nmiheer715-hue/JalSense/docs/images/dashboard-bypass.png

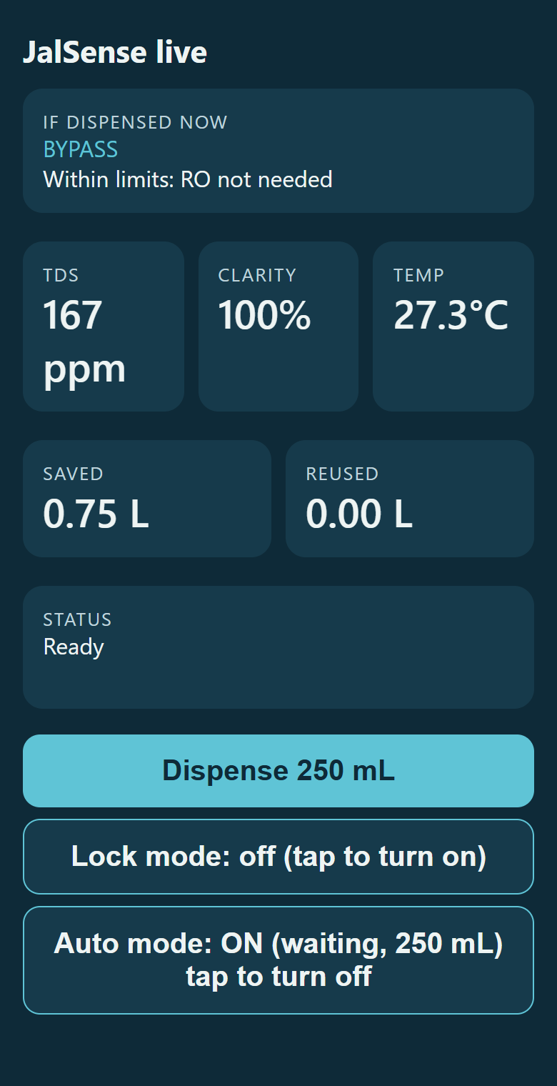
docs/images/dashboard-bypass.png
