nmiheer715-hue/JalSense/docs/images/dashboard-ro.png

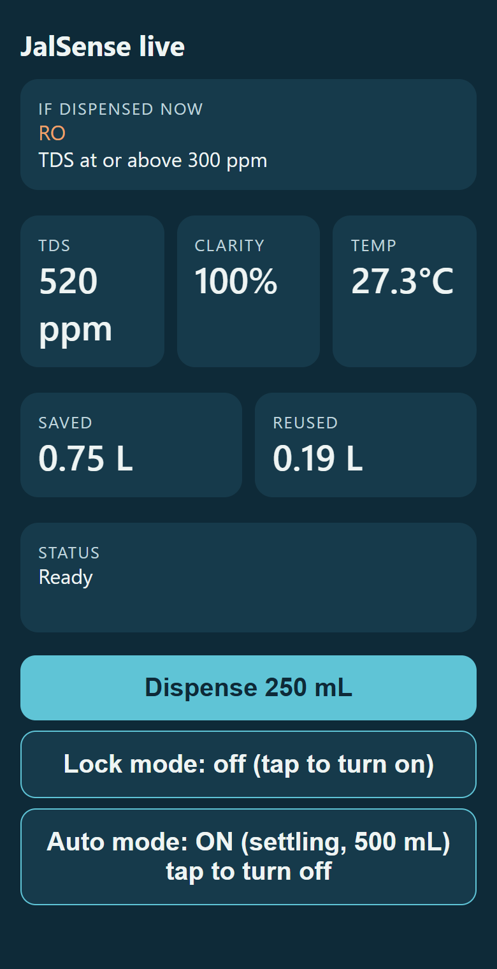
docs/images/dashboard-ro.png
