nmiheer715-hue/JalSense/hardware/jalsense-retrofit-exploded-view.png

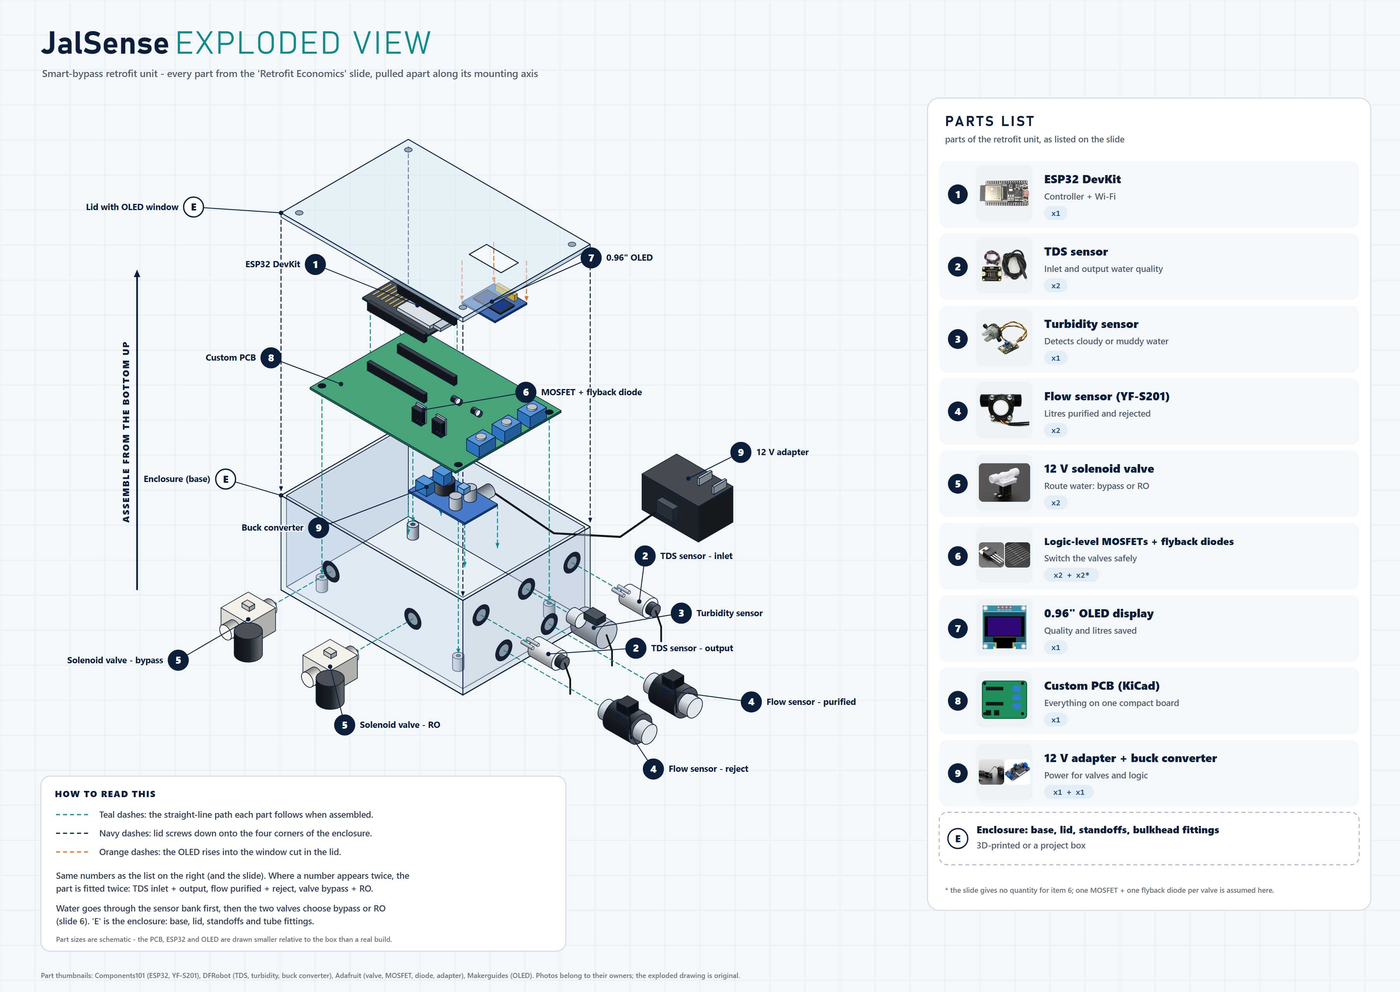
hardware/jalsense-retrofit-exploded-view.png
