nmiheer715-hue/JalSense/hardware/bom.csv

Part | Qty | Job
ESP32-WROOM-32 DevKit (38-pin) | 1 | Controller, Wi-Fi dashboard
Analog TDS meter V1.0 | 1 | Dissolved salts in the inlet water
Turbidity sensor with module | 1 | Detects cloudy water
DS18B20 waterproof probe (1 m) | 1 | Temperature compensation for TDS
YF-S201 water flow sensor | 1 | Litres on the bypass path
5 V dual relay module with optocoupler | 1 | Switches pump A and pump B
DC 3-6 V mini submersible pump | 2 | Pump A = bypass, pump B = RO
0.96" OLED I2C (SSD1306 or SH1106) | 1 | Live readings and decision
5 V 2 A adapter | 1 | Powers everything
DC jack female pigtail 2.1 x 5.5 mm | 1 | Adapter to breadboard rails
MB102 830-point breadboard | 1 | Holds the circuit
Resistors (six of one value: 10k design, 5.5k as built) | 6 | Dividers R1 to R4 and DS18B20 pull-up R5
Capacitor 470 uF 16 V | 1 | Supply dip at pump start
6 mm silicone tube (1 m) | 1 | Pump outlets to the jars
