nmiheer715-hue/JalSense/hardware/jalsense-breadboard-build-v2.png

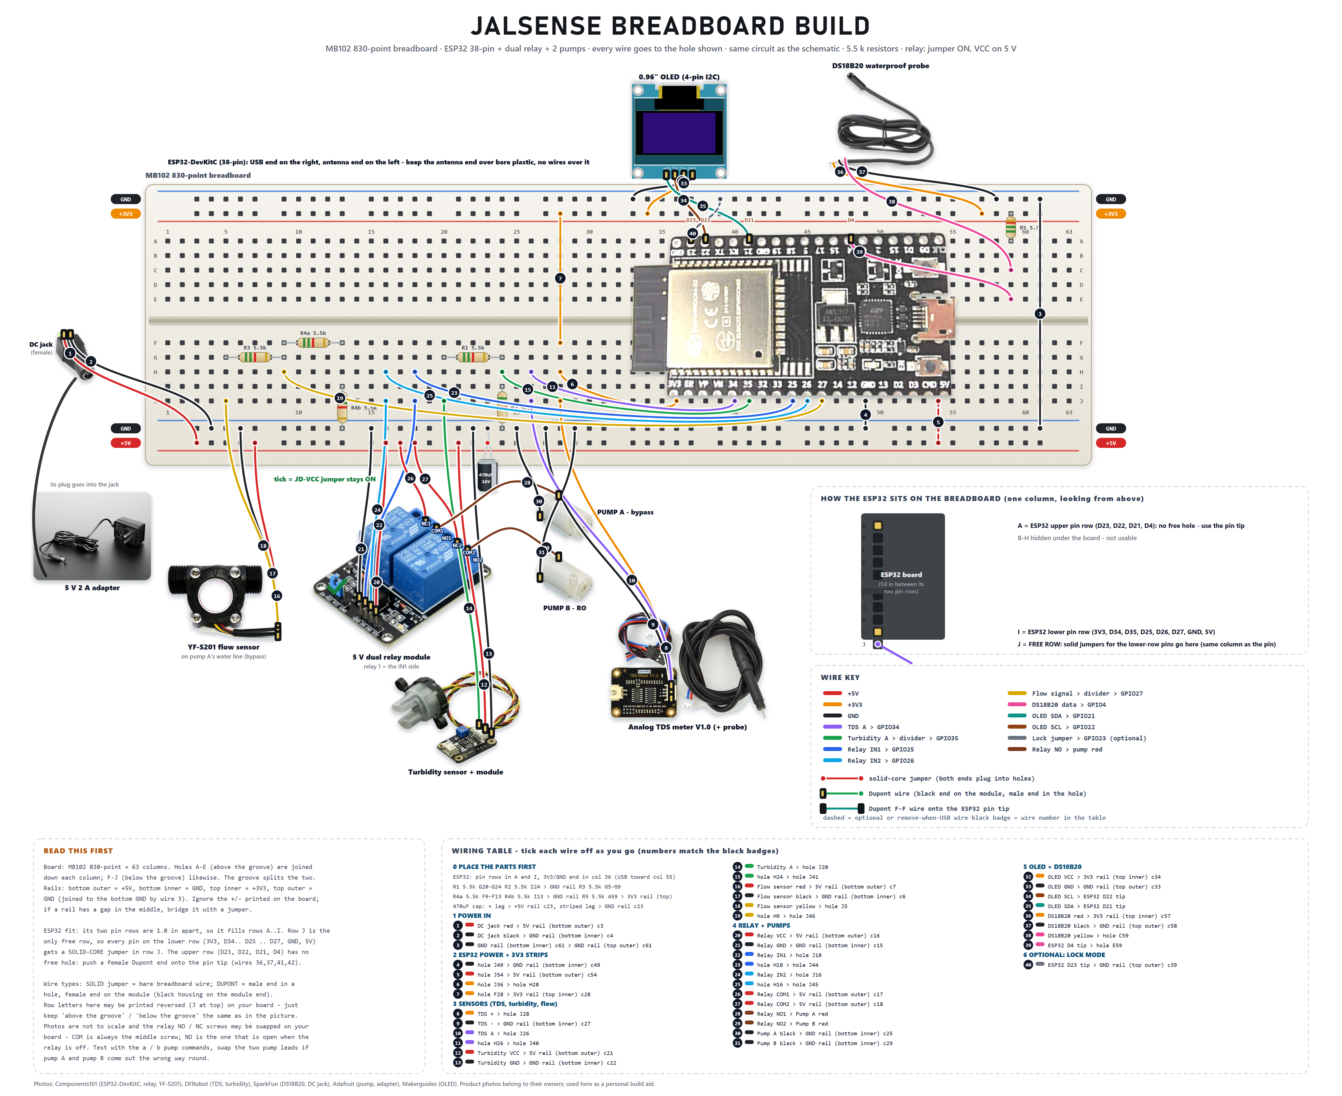
hardware/jalsense-breadboard-build-v2.png
