nmiheer715-hue/JalSense/hardware/jalsense-wiring.png

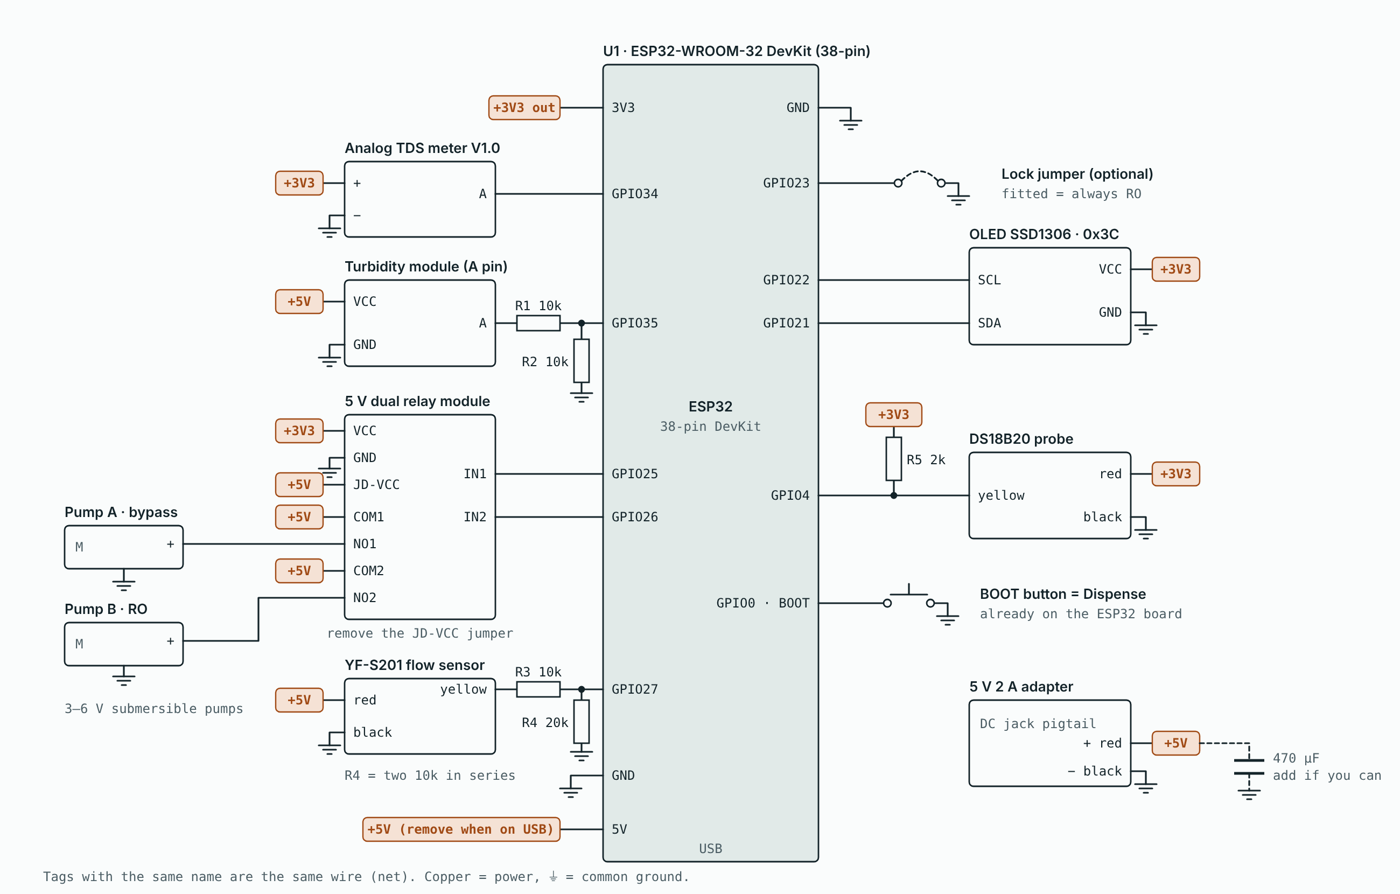
hardware/jalsense-wiring.png
