nmiheer715-hue/JalSense/(commit log)

2026-10-10 JalSense: firmware, schematics and docs for the SDG 6 RO retrofit
    ESP32 firmware with fail-safe bypass/RO decision, ADS1115 sensing,
    flow metering and phone dashboard; three schematic sheets, parts list,
    wiring table, calibration, design notes, FAQ and demo script.
    Claude-Session: https://claude.ai/code/session_01VPnfr1mdaY5D5fYLJCe19C
    [bom.csv]
2026-10-10 Rebuild around the ordered parts: relay + two pumps, ESP32 ADC
    - Firmware: ESP32 ADC sensing (150 mV fault floor), active-LOW dual relay
    driving pump A (bypass) and pump B (RO), flow metering on the bypass
    line, timed metering on the RO path, BOOT button dispense, GPIO23 or
    phone lock mode, pump-rate calibration, Wokwi build flag
    - New wiring diagram (SVG + PNG) replacing the three schematic sheets
    - Wokwi simulation project (diagram.json, sketch, libraries)
    - Parts list, wiring table, calibration, design notes, FAQ, demo script
    and troubleshooting updated; no custom PCB
    Claude-Session: https://claude.ai/code/session_01VPnfr1md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
    [bom.csv]
2026-10-10 Correct prototype parts total to about Rs 2,100
    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
2026-10-18 Check clarity before TDS in the decision logic
    TDS (dissolved salts) and turbidity (suspended particles) are independent,
    so low-TDS water can still be cloudy. Clarity is now checked first so the
    reported reason names the visible problem first. Flowchart, README and
    design notes updated; firmware and Wokwi sketch recompiled.
    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
    [JalSense.ino, sketch.ino]
2026-10-24 Add auto mode firmware, OLED fix, live dashboard docs and prototype notes
    - firmware/JalSense_auto: auto mode with safety limits, SH1106 OLED support, faster Wi-Fi hotspot
    - firmware/tools: OLED_test and OLED_test2 (display and I2C checks)
    - docs: phone dashboard (how to monitor the results), prototype build notes, one-page build and demo guide
    - hardware: schematic of the built prototype (v2)
    - README: latest build, live dashboard section, updated layout
    [JalSense_auto.ino, OLED_test.ino, OLED_test2.ino]
2026-10-24 Update docs and hardware files to match the prototype as built
    - hardware: as-built schematic link, resistor values are ratios (5.5 k built), relay wiring options,
    pump wiring (NO not COM), power notes, SH1106 OLED, 470 uF capacitor in the BOM
    - calibration: TDS single-point calibration range, saturation above 1000 ppm, k check, new settings
    - troubleshooting: OLED SH1106, relay and pump wiring, TDS k, temperature probe, upload and Wi-Fi tips
    - README: prototype power and OLED rows, status (bench prototype running), TDS range limit
    - guide: decision order matches the repo (clarity before TDS)
    [bom.csv]
2026-10-24 Remove all prices; add breadboard layout and exploded views
    - remove every price and the total from the README, hardware README, bom.csv and FAQ
    - hardware: breadboard layout (v2), prototype exploded view (HD and 4K), retrofit exploded view
    (rebuilt without prices), listed in a new Build sheets table with a photo-credit note
    - README: exploded view embedded, links to the sheets
    [bom.csv]
2026-10-24 README: show the as-built schematic on the page
2026-10-24 firmware: faster Wi-Fi hotspot in the original JalSense.ino
    Power-save off, fixed 192.168.4.1, channel 6, up to 2 phones (same settings as JalSense_auto).
    [JalSense.ino]
2026-10-24 firmware: SH1106 OLED support and 100 kHz I2C in the original JalSense.ino
    OLED_IS_SH1106 = true writes the frame page by page (SH1106 chips); start-up screen wipe.
