nmiheer715-hue/JalSense/(notices)

Notices in the files:
README.md:
License: MIT
